manimanis/PFE-Maitrise/Extra/PrayerCall/interface.png

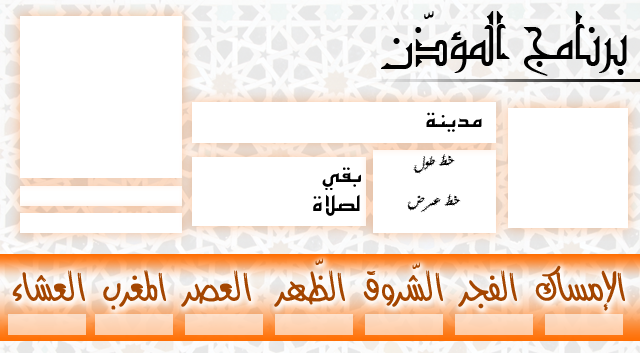
Extra/PrayerCall/interface.png
