manimanis/PFE-Maitrise/Readme.txt

Présentation Générale

PFE       : Prayers Caller
Etudiant  : MANI Mohamed Anis
N°        : 18498
Encadreur : Mr BESKRI Charfeddine

Le CD est organisé afin de faciliter la recherche des données.
