manimanis/PFE-Maitrise/Rapport/Annexes.pdf

Annexes

i

# Annexes

ii

## Sommaire

iii

## Liste des Figures

Figure 18, fenêtre d'édition des coordonnées géographiques d'une ville : VilleEditDialog

Figure 20, fenêtre d'édition des horaires de prières pour une ville : PrayersTimesDialog

Figure 21, fenêtre d'édition des horaires de prières pour une journée : PrayersEditDialog

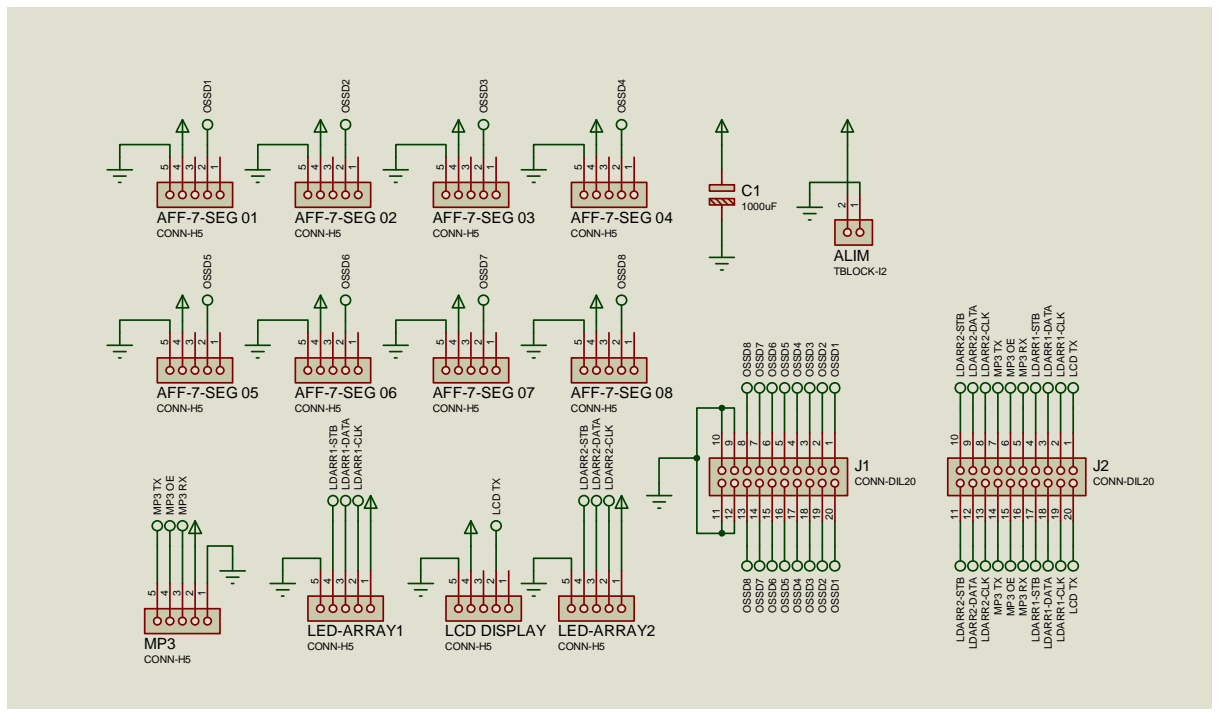
[picture p2: figure]
AFF-7-SEG 02; CONN-H5; OSSD2; AFF-7-SEG 01; OSSD1; AFF-7-SEG 03; OSSD3; AFF-7-SEG 04; OSSD4; AFF-7-SEG 05; OSSD5; LED-ARRAY1; CONN-H5 LDARR¹⁻STB LDARR¹⁻DATA LDARR1-CLK; ALIM; TBLOCK-I2; CONN-H5 MP³ TX MP³ OE MP³ RX; LCD DISPLAY; LCD TX; AFF-7-SEG 06; OSSD6; AFF-7-SEG 07; OSSD7; AFF-7-SEG 08; OSSD8; LED-ARRAY2; CONN-H5 LDARR²⁻STB LDARR²⁻DATA LDARR2-CLK; CONN-DIL20; LDARR2-STB; LDARR2-DATA; LDARR2-CLK; LDARR1-STB; LDARR1-DATA; LDARR1-CLK; LCD TX LCD TX

iv

# Annexe 1 -Schémas des montages électroniques

Les schémas de principe ont été dessinés à l'aide Proteus 7.7.
Le routage a été réalisé à l'aide de ARES. Ce logiciel offre une fonction de routage automatique. Cette fonction est très performante pour les circuits double faces. Pour les circuits simple face le résultat reste toujours décevant.

J'ai eu le choix entre :
- Utiliser des circuits imprimés double face pour bénéficier du routage automatique.
- Utiliser des circuits imprimés simple face et effectuer le routage manuellement.
La première solution présente aussi un inconvénient très grand lors de la soudure des composants : certains composants doivent être soudés sur les deux faces sans oublier les vias.
La deuxième solution semble plus adéquate bien : il faudrait passer des heures pour effectuer le routage tout en garantissant que le montage fonctionnera dès sa mise sous tension.

### 1. Commande des composants périphériques

Le montage suivant (figure 1) n'a d'autre utilité que de relier les différents modules du système avec le module principal.

Figure 1, Liaison entre le module principal et les afficheurs 7 segments

### 2. Module Affichage du jour de la semaine

# CONN-H5RX

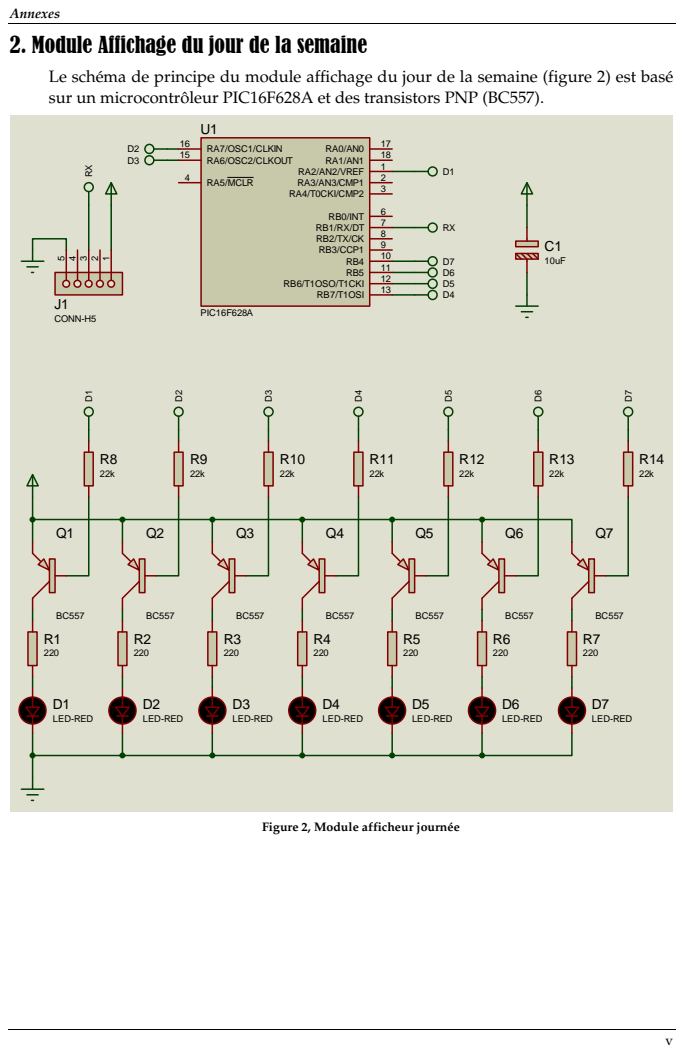
[picture p3: page 5]

Le schéma de principe du module affichage du jour de la semaine (figure 2) est basé
sur un microcontrôleur PIC16F628A et des transistors PNP (BC557).

Figure 2, Module afficheur journée

vi

### 3. Module d'alimentation

Le module d’alimentation (figure 3) supporte une tension d’entrée de 7,5V à 30V. Le régulateur utilisé (LM123K) est un régulateur fixe 5V - 3A. Il est monté sur le bornier J1.

Ce régulateur doit être monté sur un dissipateur thermique car la puissance maximale estimée dissipée est de l’ordre de :

Pdissipée = Udiff x Amax = (12 – 5) x 2 = 14W

La diode D1 sur l’entrée du module permet de protéger les condensateurs chimiques de filtrage contre une inversion de tension. Les condensateurs chimiques sont des condensateurs polarisés qui risquent d’exploser si on leur applique une tension négative.
La diode D2 est montée en cascade du régulateur afin de le protéger lors de la mise hors tension du montage. Les condensateurs en amont du régulateur se déchargent avant ceux situés en aval. Ce phénomène risque de créer une tension inverse aux bornes du régulateur qui pourrait le griller. La diode D2 conduit lors de la mise hors tension du montage pour permettre aux condensateurs en aval du régulateur de se décharger.

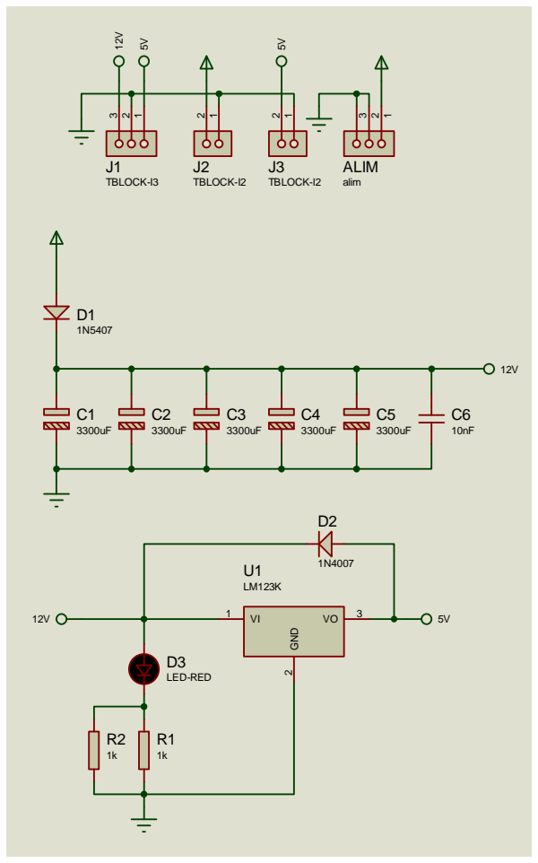
[picture p4: figure]
TBLOCK-I3 ¹²V; TBLOCK-I2; TBLOCK-I2 ⁵V; LED-RED; ALIM; alim; GND

Figure 3, Module d'alimentation

### 4. Module MP3

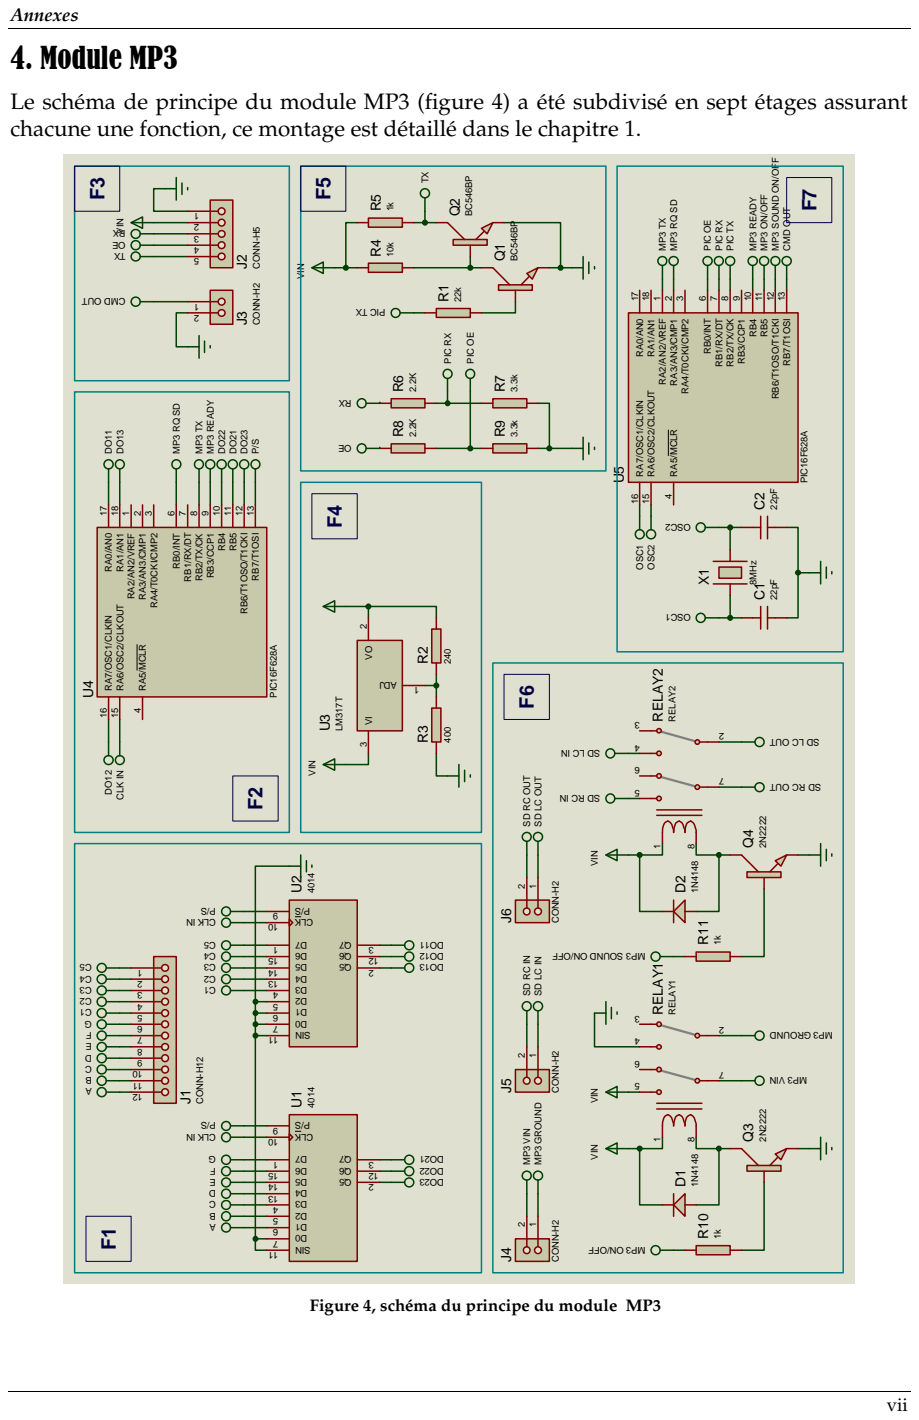
[picture p5: page 7]

Le schéma de principe du module MP3 (figure 4) a été subdivisé en sept étages assurant
chacune une fonction, ce montage est détaillé dans le chapitre 1.

Figure 4, schéma du principe du module MP3

### 5. Module afficheur LCD série

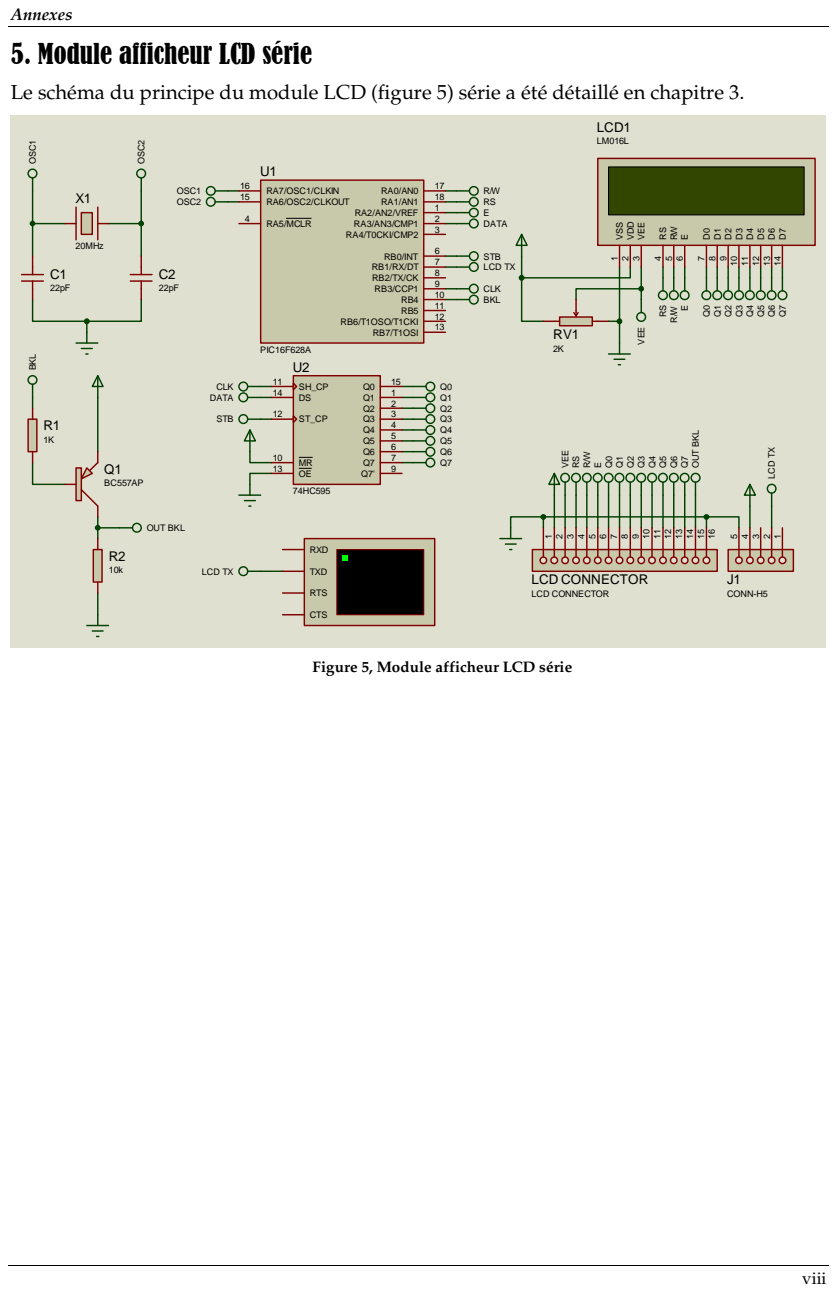
[picture p6: page 8]

Le schéma du principe du module LCD (figure 5) série a été détaillé en chapitre 3.

Figure 5, Module afficheur LCD série

### 6. Module afficheur 7 segments

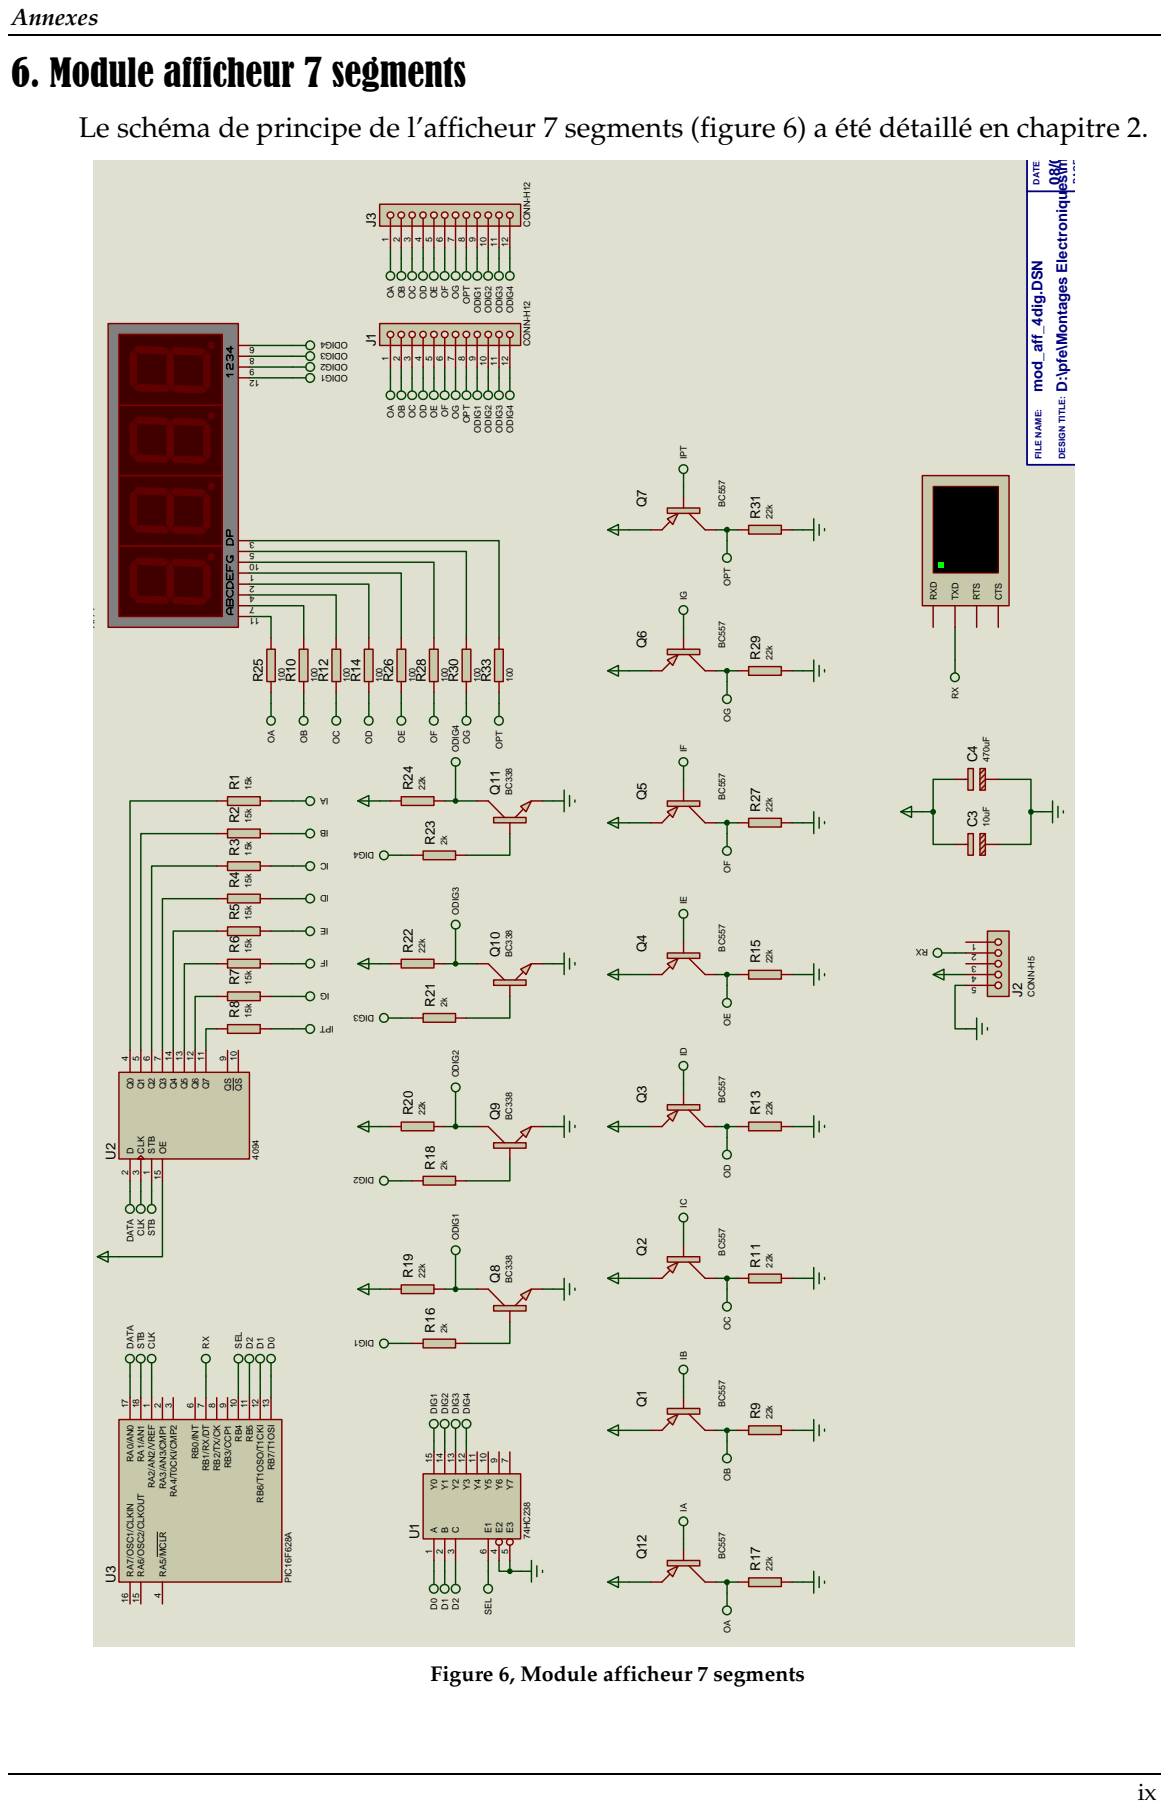
[picture p7: page 9]

08/09/2011 DESIGN TITLE: D:\pfe\Montages Electroniques\mod_aff_4digits\mod_a

Le schéma de principe de l’afficheur 7 segments (figure 6) a été détaillé en chapitre 2.

Figure 6, Module afficheur 7 segments

### 7. Module Principal

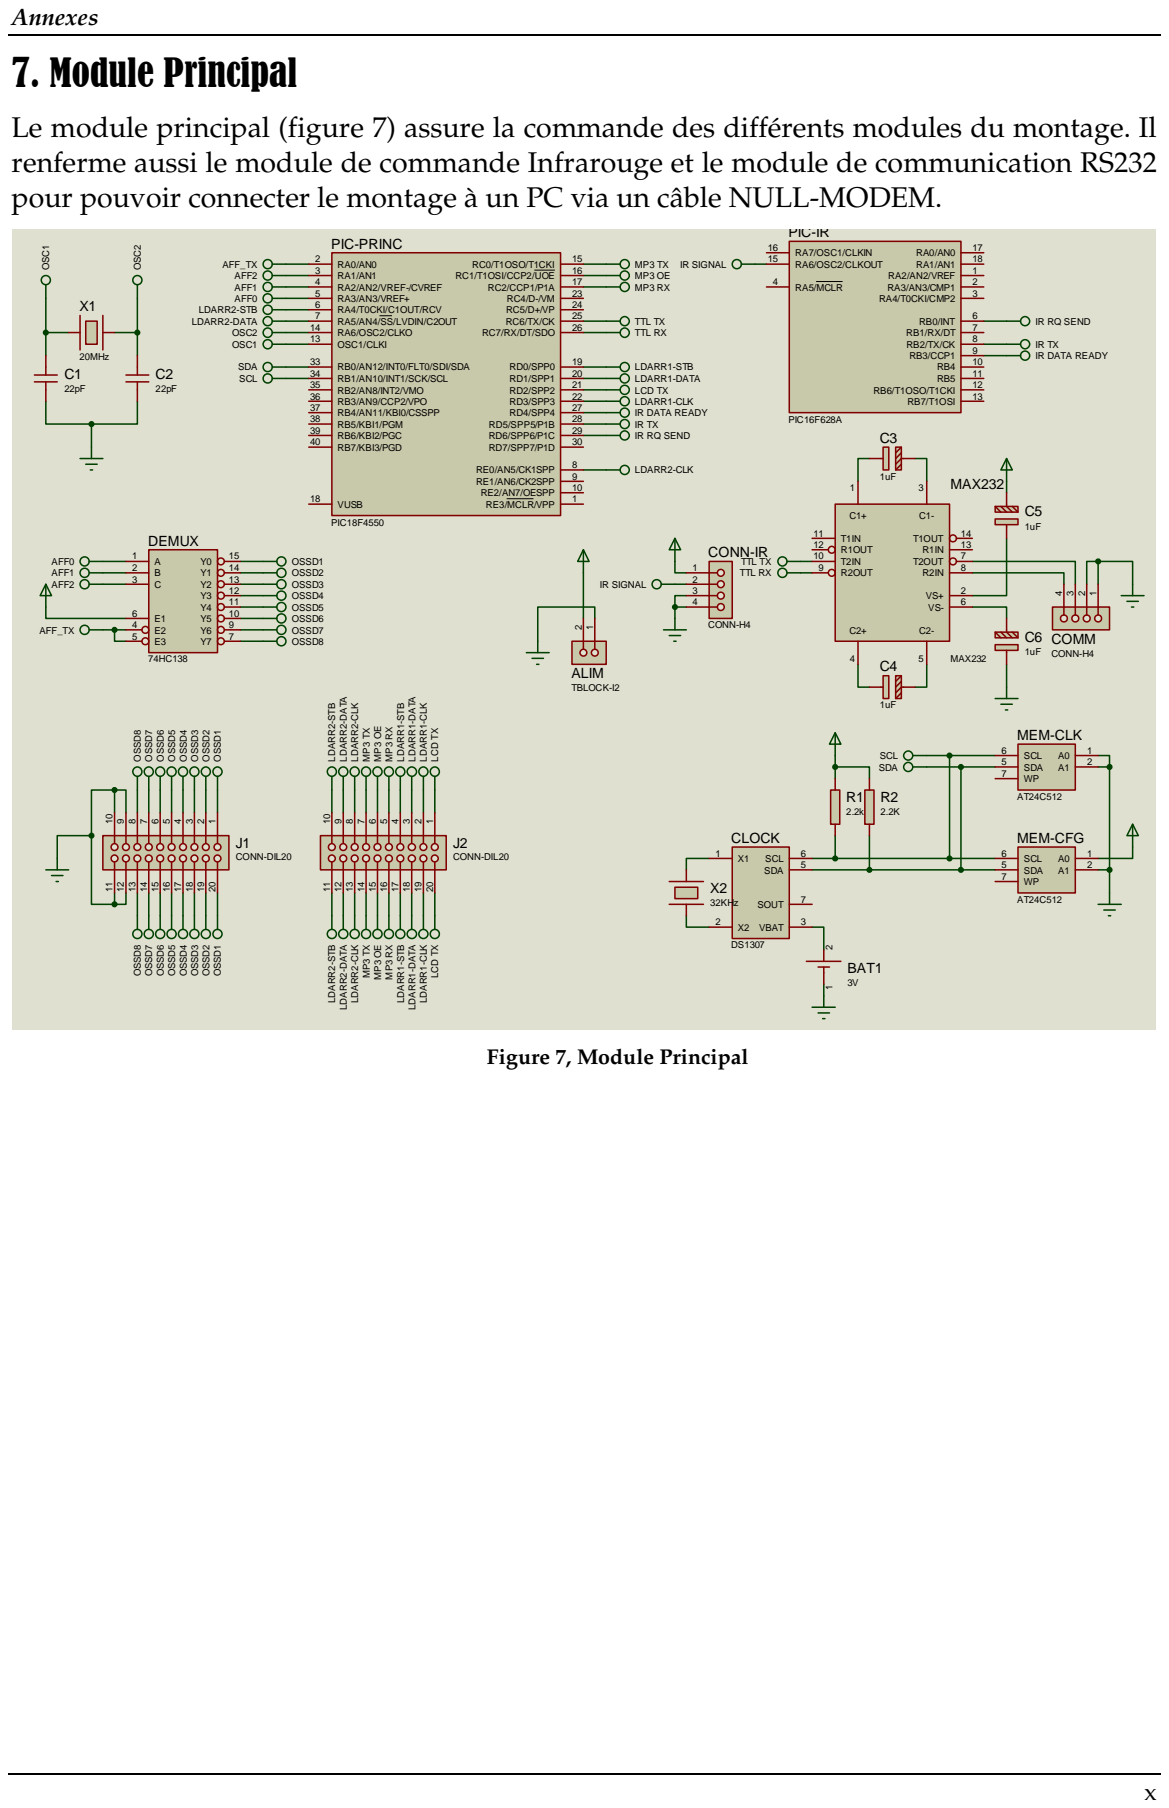
[picture p8: page 10]

Le module principal (figure 7) assure la commande des différents modules du montage. Il
renferme aussi le module de commande Infrarouge et le module de communication RS232
pour pouvoir connecter le montage à un PC via un câble NULL-MODEM.

LCD TX

xi

## Annexe 2 - Modèle de domaine

Dans ce modèle de domaine (figure 8) on essaye d’identifier les objets réels entrant dans la composition du système et de leurs attribuer des noms non ambigües.
Les noms attribués aux objets seront utilisés par la suite dans la rédaction des Use Cases.

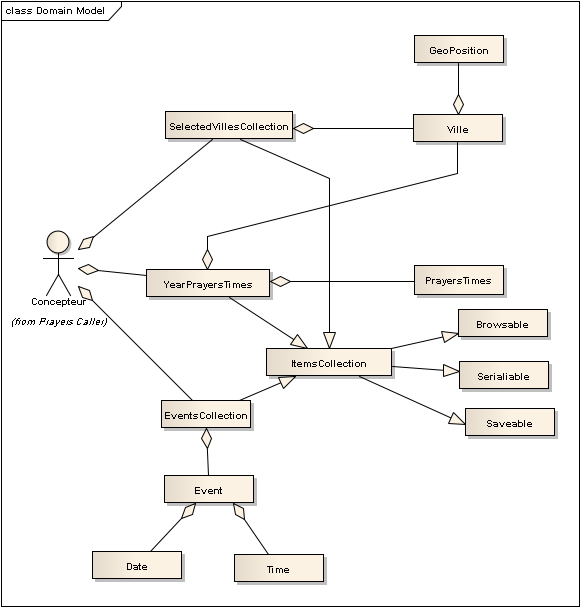
[picture p9: figure]

Figure 8, Modèle de domaine

xii

## Diagrammes de cas d'utilisation

### 1. Packages

Les packages permettent d’organiser l’ensemble des Use Cases (figure 9). Comme notre application assure cinq fonctions, les use cases ont été divisés conformément à ce nombre.
Les fonctions assurées sont :
- Sélectionner villes
- Editer coordonnées villes
- Editer horaires de prières
- Gérer les évènements
- Générer fichier Hex

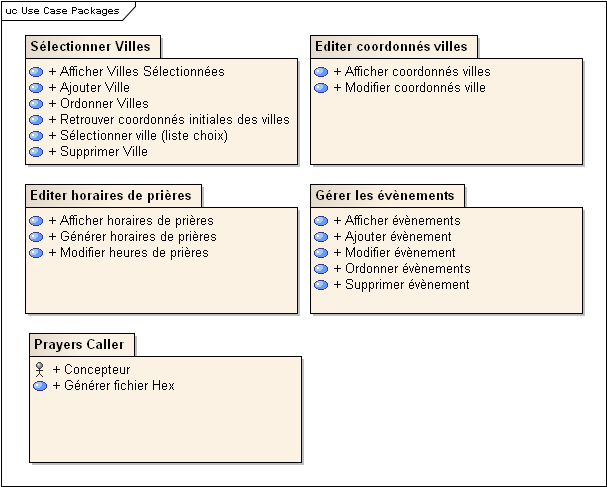
[picture p10: figure]

Figure 9, diagramme de packages

xiii

### 2. Diagramme Use case : Sélectionner ville

Le diagramme Use case : Sélectionner ville (figure 10) montre les actions que le concepteur (acteur du système) puisse réaliser dans le contexte du Use Case (Chapitre 7.2.a).

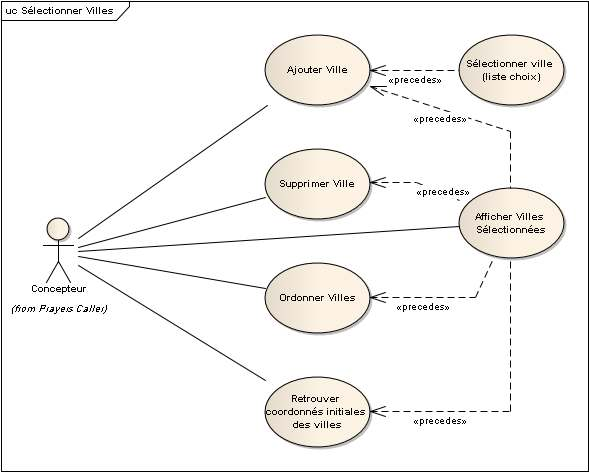
[picture p11: figure]

Figure 10, diagramme use case sélectionner ville

### 3. Diagramme Use case : Editer coordonnée villes

Le diagramme use case éditer coordonnées villes (figure 11) permet au concepteur de consulter la liste des villes sélectionnées, afficher et éditer leurs coordonnées (Chapitre 7.2.b).

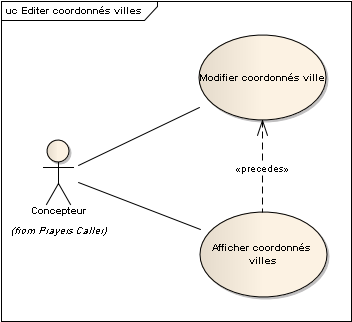
[picture p12: figure]

Figure 11, diagramme use case éditer coordonnées villes

### 4. Diagramme Use case : éditer horaires de prières

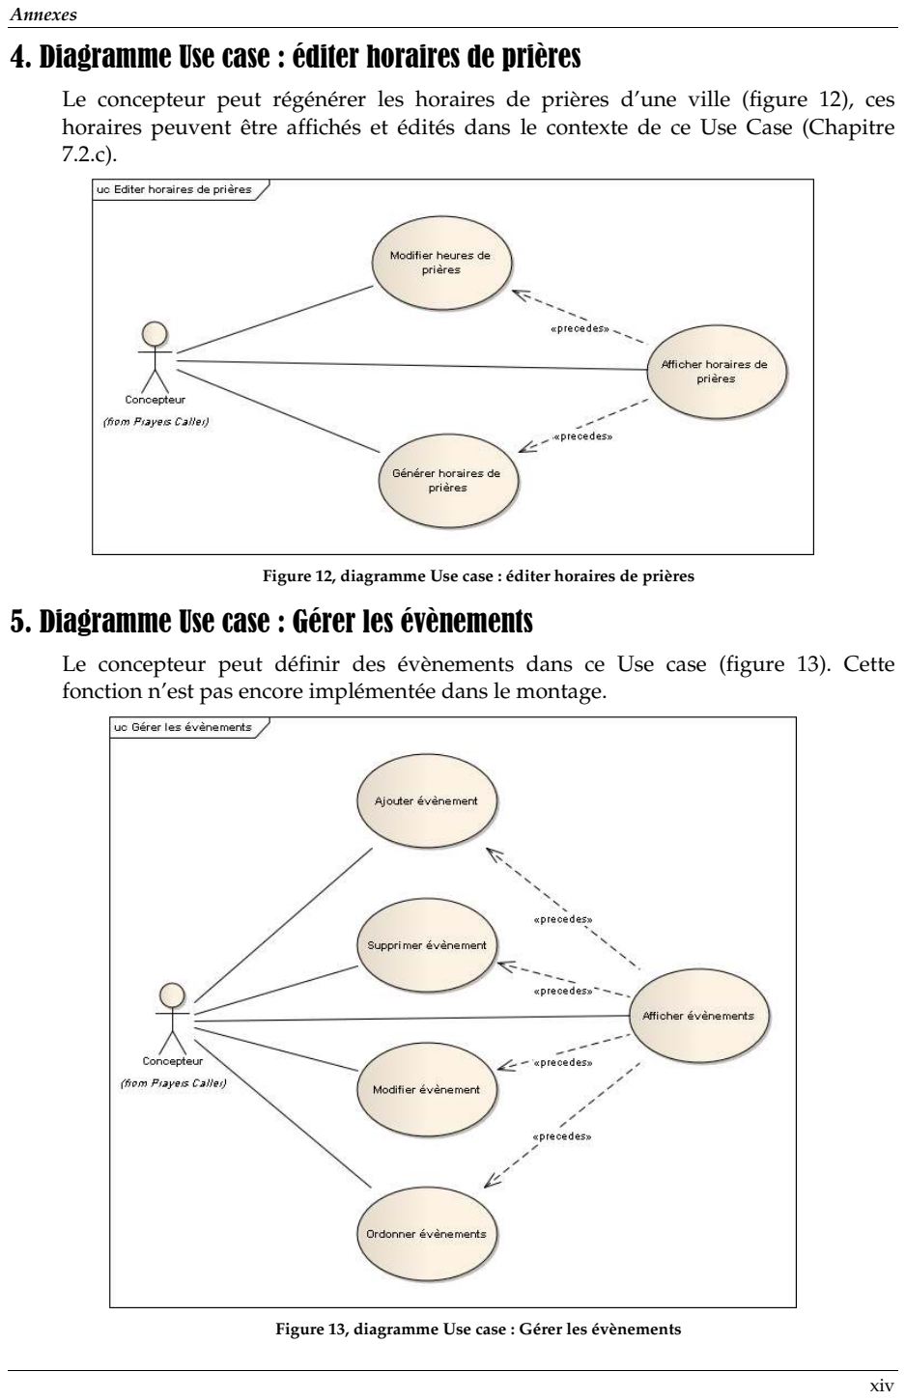
[picture p13: page 14]

xiv

Le concepteur peut régénérer les horaires de prières d’une ville (figure 12), ces horaires peuvent être affichés et édités dans le contexte de ce Use Case (Chapitre 7.2.c).

Figure 12, diagramme Use case : éditer horaires de prières

### 5. Diagramme Use case : Gérer les évènements

Le concepteur peut définir des évènements dans ce Use case (figure 13). Cette fonction n’est pas encore implémentée dans le montage.

Figure 13, diagramme Use case : Gérer les évènements

xv

### 6. Diagramme Use case : Prayer Caller

Le but ultime de cette application étant de pouvoir générer le fichier Hex, le Use Case (figure 14) suivant permet d’assurer cette fonction (Chapitre 7.2.d).

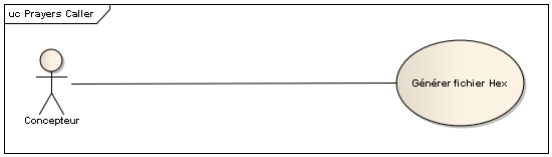
[picture p14: figure]

Figure 14, diagramme Use case : Prayer Caller

xvi

## Annexe 3 - Captures d'écran de l'interface de l'utilitaire PrayerCaller

### 1. MainFrame

La fenêtre principale de l’application (figure15).

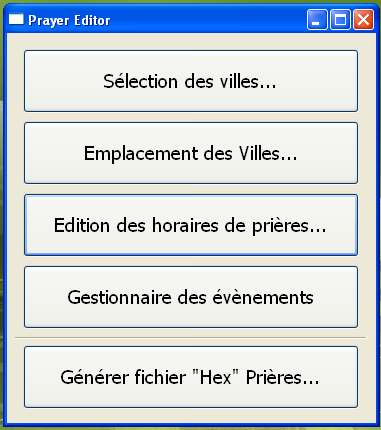
[picture p15: figure]

Figure 15, fenêtre principale : MainFrame

### 2. TownsSelectDialog

L’apparence de la fenêtre qui permet d’assurer le cas d’utilisation : Sélectionner villes (figure 16).

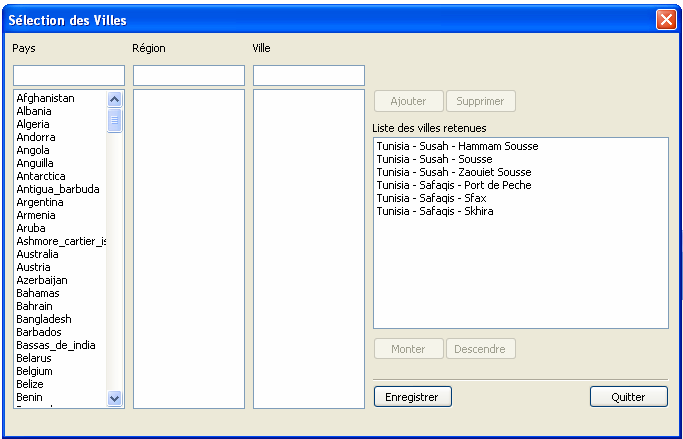
[picture p16: figure]

Figure 16, fenêtre de sélection de villes : TonwsSelectDialog

xvii

### 3. VillesDialog

La fenêtre suivante permet d’afficher les coordonnées des villes sélectionnées (figure 17).

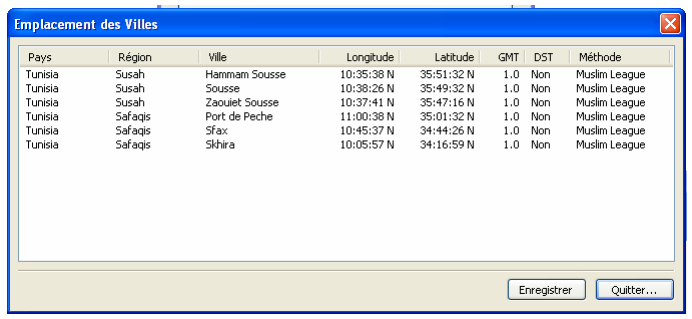
[picture p17: figure]

Figure 17, fenêtre d'édition des coordonnées des villes : VillesDialog

### 4. VilleEditDialog

Une ville sélectionnée dans la fenêtre VillesDialog peut être éditée grâce à la fenêtre suivante (figure 18).

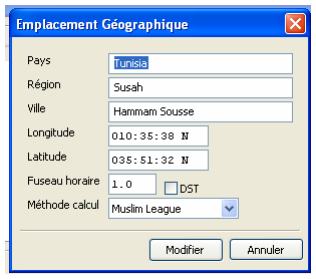
[picture p18: figure]

Figure 18, fenêtre d'édition des coordonnées géographiques d'une ville : VilleEditDialog

### 5. VilleChoiceDialog

Pour pouvoir générer/éditer les horaires de prières d’une ville il faudra commencer par la sélectionner dans la liste de la fenêtre suivante (figure 19).

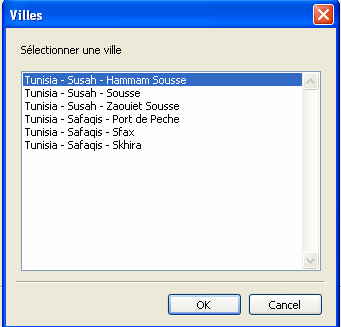
[picture p19: figure]

Figure 19, fenêtre de sélection d'une ville : VilleChoiceDialog

xviii

### 6. PrayersTimesDialog

La fenêtre suivante (figure 19) présente les horaires de prières d’une ville pour tous les jours de l’année. Le concepteur peut régénérer les horaires de prières si celles-ci ont été éditées d’une façon incorrecte.

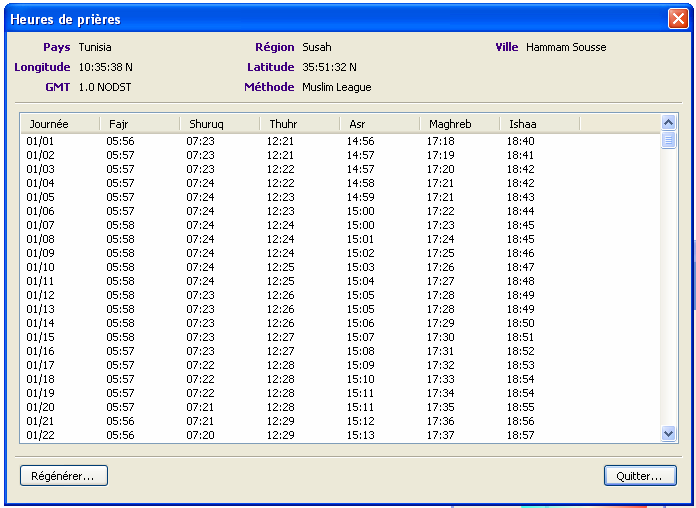
[picture p20: figure]

Figure 20, fenêtre d'édition des horaires de prières pour une ville : PrayersTimesDialog

### 7. PrayersEditDialog

L’édition des horaires de prières pour une journée est effectuée à travers la fenêtre suivante (figure 21). Cette fenêtre est accessible via un double clic sur un élément de la liste présentée dans la fenêtre PrayersTimesDialog.

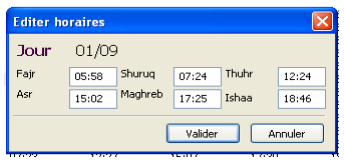
[picture p21: figure]

Figure 21, fenêtre d'édition des horaires de prières pour une journée : PrayersEditDialog

xix

### 8. EventsDialog

L’édition, l’ajout, la suppression, l’ordre des évènements sont accessibles à travers la fenêtre suivante (figure 22).

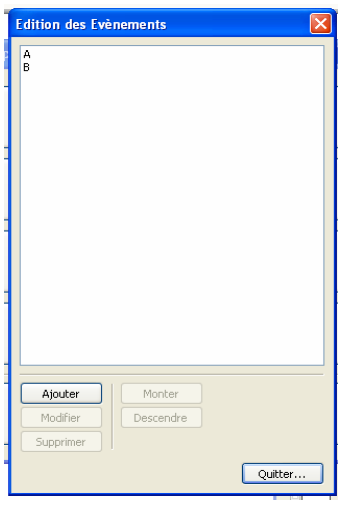
[picture p22: figure]

Figure 22, fenêtre d'édition des évènements :EventsDialog

### 10. EventsEditDialog

Le concepteur peut choisir la nature, la fréquence, les dates de déclenchement et les intervalles des évènements. Ces actions sont réalisées à travers la fenêtre suivante (figure 23). Cette partie reste non implémentée pour le moment.

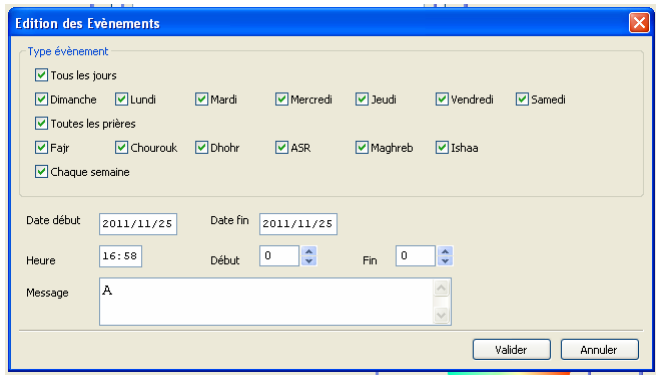
[picture p23: figure]

Figure 23, fenêtre d'édition d'un évènement : EventsEdirDialog
