manimanis/PFE-Maitrise/Rapport/page de garde.pdf

Institut Supérieur de l'Education et de la Formation Continue

Ministère de l'enseignement Supérieur

# Projet de fin d'études

# Conception et réalisation du prototype d'un montage pour afficher les horaires de prières

Réalisé Par

## MANI Mohamed Anis

Encadré Par

## Mr BESKRI Charfeddine

Semestre 57

2010/2011
