manimanis/PFE-Maitrise/Montages/Alimentation/alimentation.PDF

J1

# TBLOCK-I3 ¹²V 5V

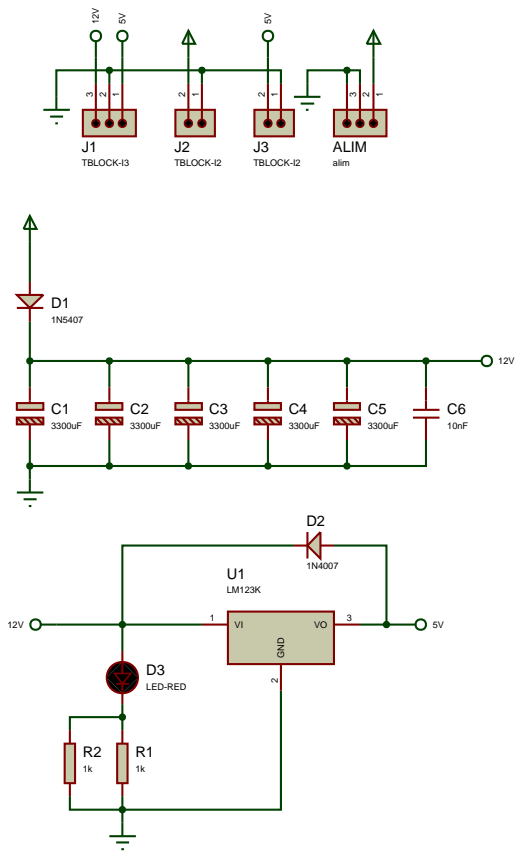
[picture p62: page 1]
