manimanis/PFE-Maitrise/Montages/Connexions/connexions.PDF

## AFF-7-SEG 02

## AFF-7-SEG 01

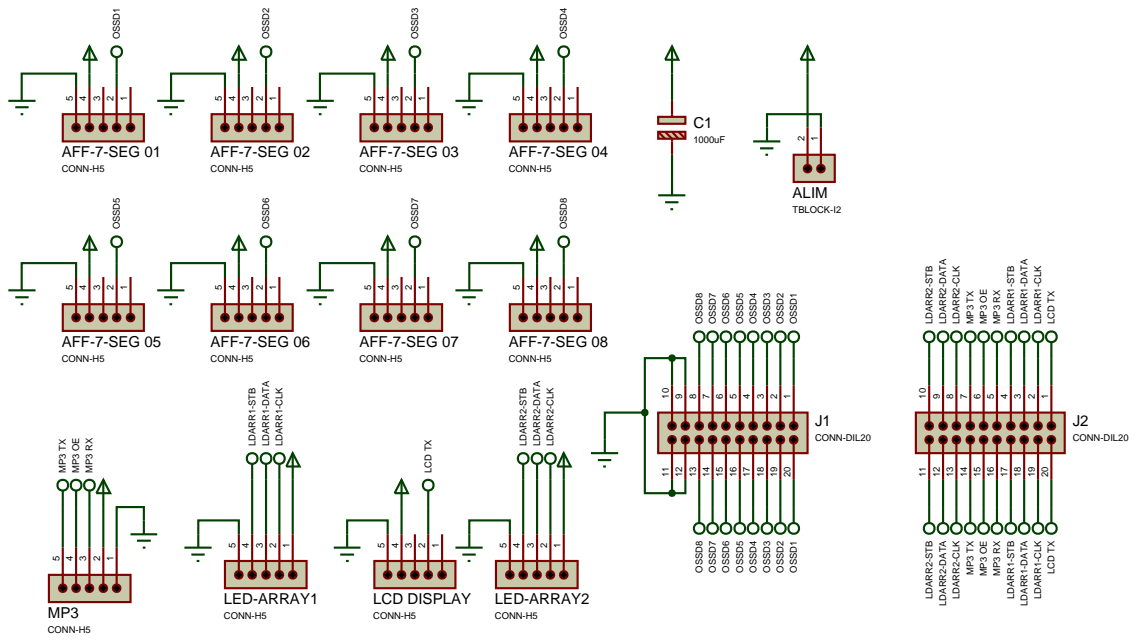
[picture p63: page 1]
CONN-H5; OSSD2; OSSD1; AFF-7-SEG 03; OSSD3; AFF-7-SEG 04; OSSD4; OSSD5; LED-ARRAY1; LDARR1-CLK; ALIM; TBLOCK-I2; LCD DISPLAY; LCD TX; OSSD6; OSSD7; AFF-7-SEG 08; OSSD8; LED-ARRAY2; LDARR2-CLK; CONN-DIL20; LDARR2-STB; LDARR2-DATA; LDARR1-STB; LDARR1-DATA

LCD TX

AFF-7-SEG 05
CONN-H5
CONN-H5 MP³ TX MP³ OE MP³ RX

AFF-7-SEG 06
CONN-H5LDARR¹⁻STB LDARR¹⁻DATA

AFF-7-SEG 07
CONN-H5LDARR²⁻STB LDARR²⁻DATA
