manimanis/PFE-Maitrise/Montages/Affichage jours/aff-jours.PDF

J1

# CONN-H5 RX

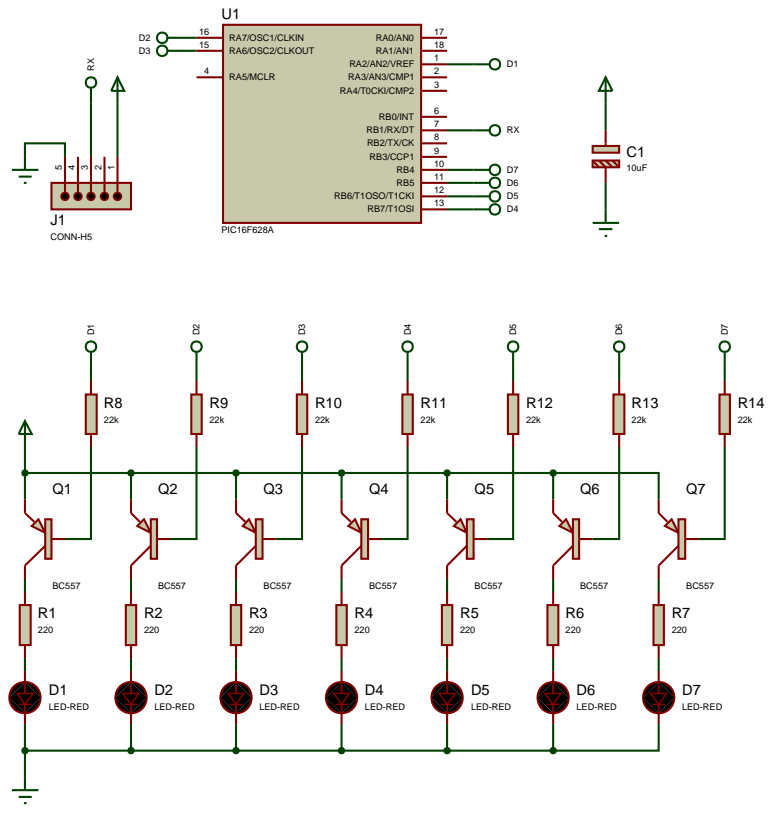
[picture p64: page 1]
