manimanis/PFE-Maitrise/Montages/Afficheur 7 segments/mod_aff_4dig.PDF

## AFF1

U2

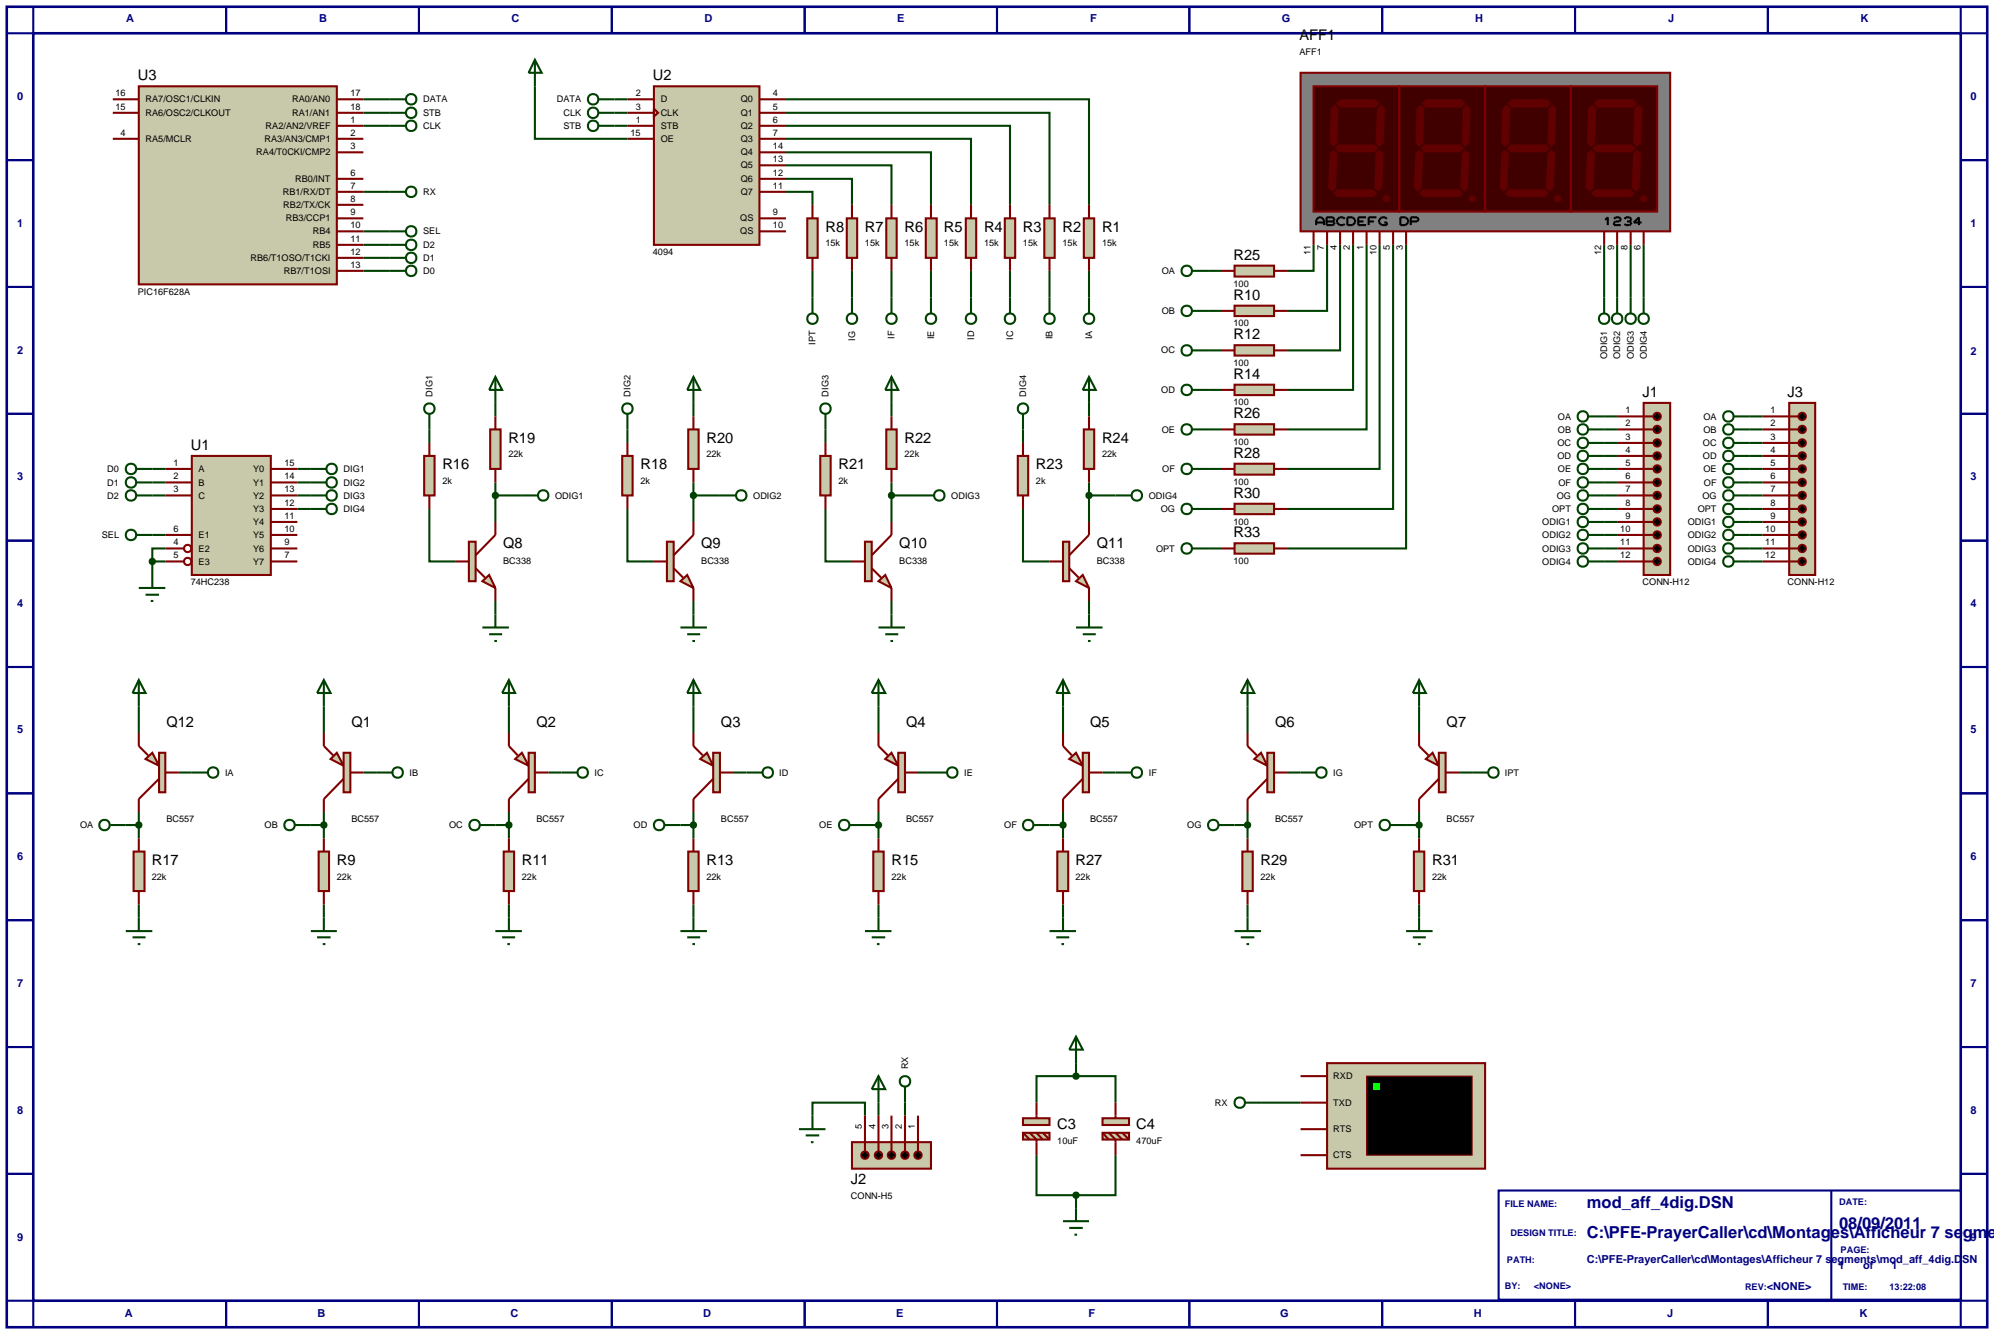
[picture p65: page 1]

FILE NAME:
DESIGN TITLE: C:\PFE-PrayerCaller\cd\Montages\Afficheur 7 segments\mod_aff_4dig.DSN
