manimanis/PFE-Maitrise/Montages/LCD Série/lcd.PDF

U1

## LCD1

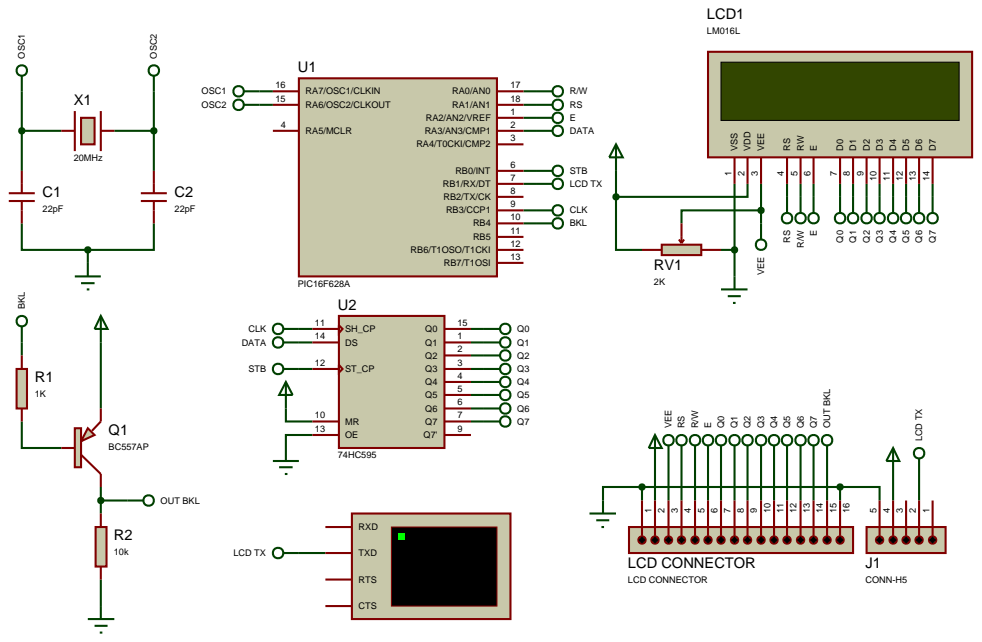
[picture p66: page 1]
