manimanis/PFE-Maitrise/Montages/Lecteur MP3/lecteur_mp3.PDF

J1

U4

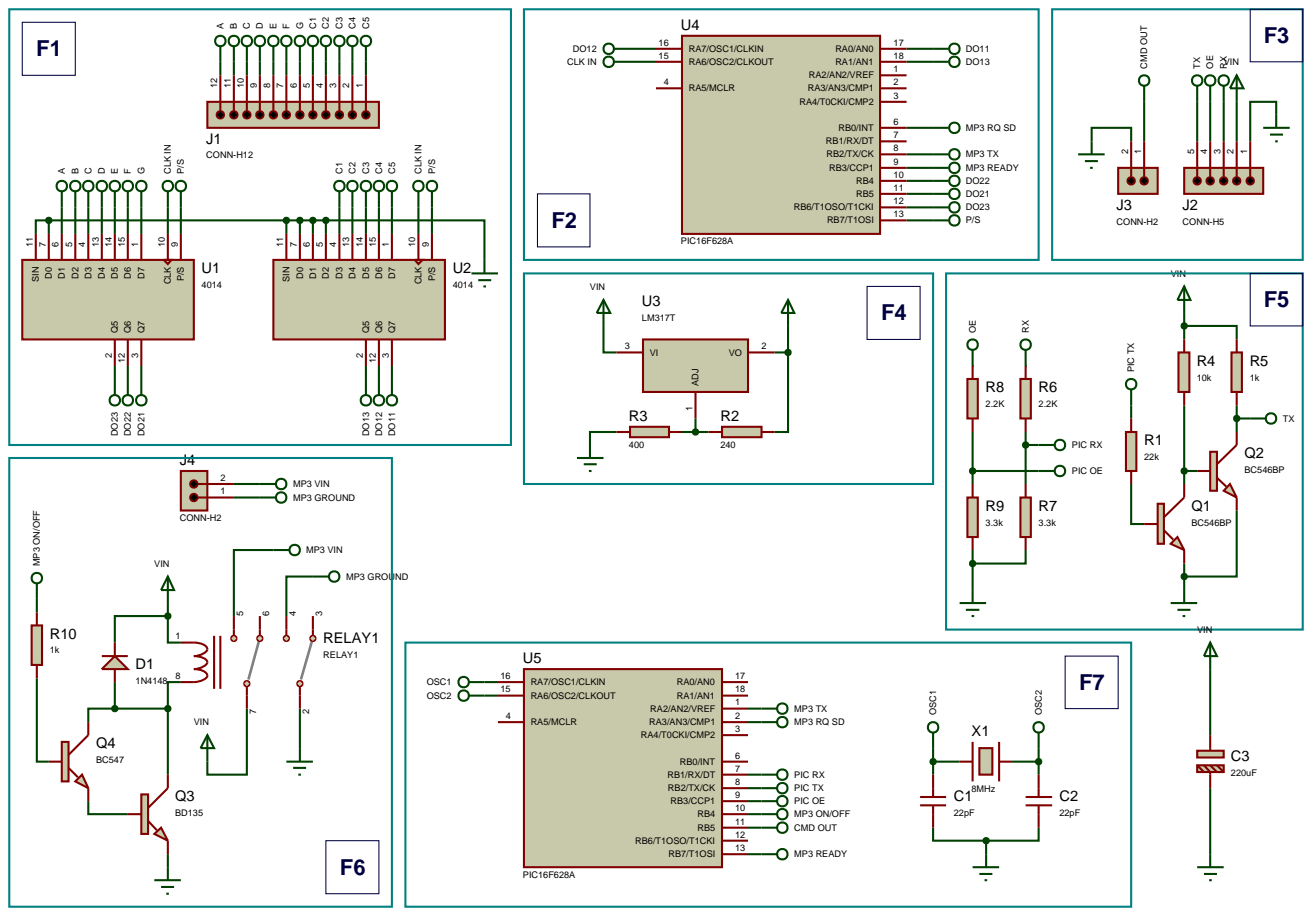
[picture p67: page 1]
