manimanis/PFE-Maitrise/Montages/Principal/principale2.PDF

## PIC-PRINC

C1

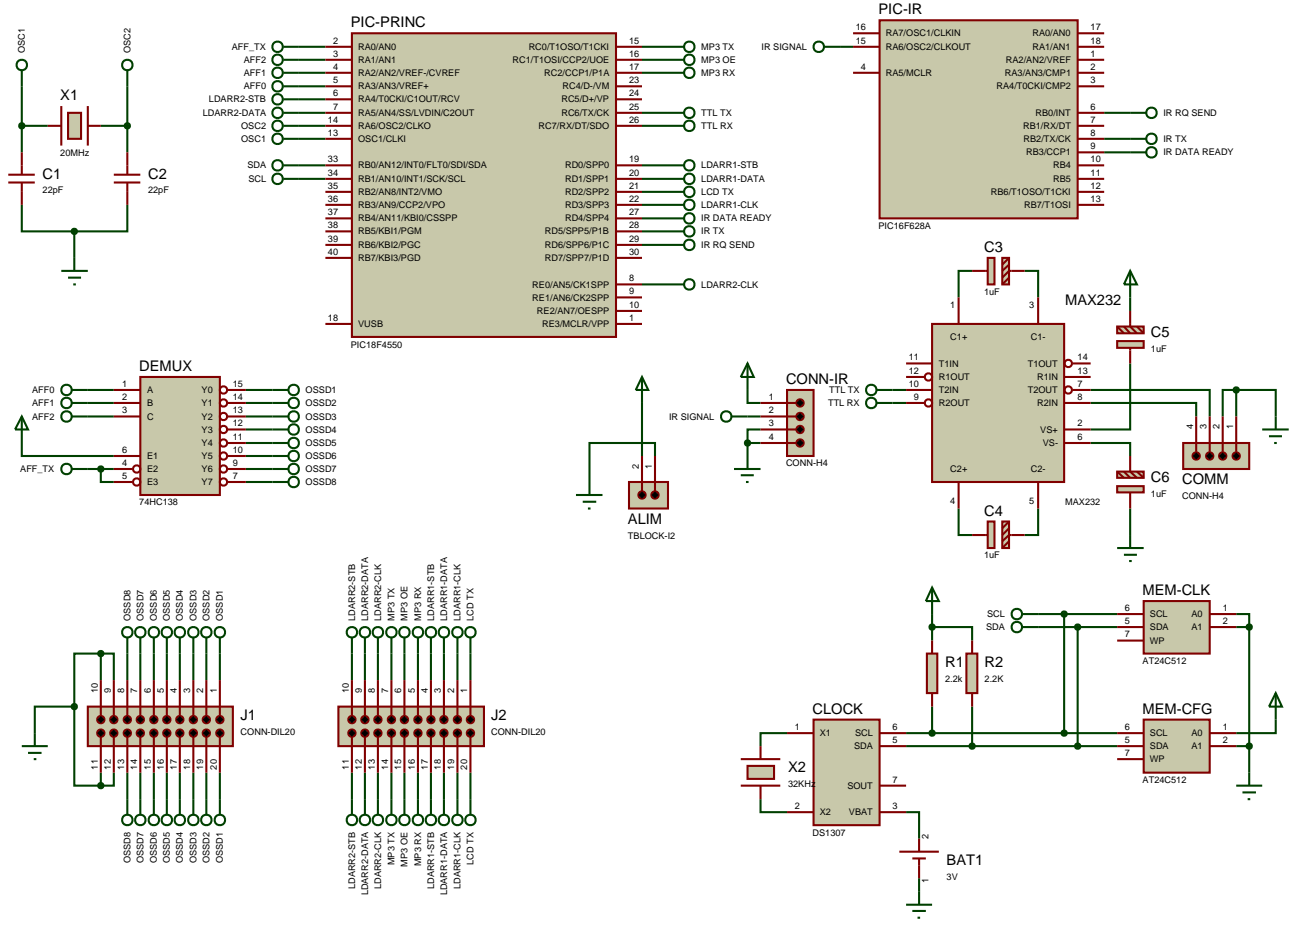
[picture p68: page 1]

LCD TX
