manimanis/PFE-Maitrise/(list of files, drawings)

Other design files:
Montages/Affichage jours/aff-jours.DSN
Montages/Affichage jours/aff-jours.LYT
Montages/Afficheur 7 segments/mod_aff_4dig.DSN
Montages/Afficheur 7 segments/mod_afficheur_4digits.LYT
Montages/Afficheur 7 segments/mod_commande.LYT
Montages/Alimentation/alimentation.DSN
Montages/Alimentation/alimentation.LYT
Montages/Alimentation/alimentation.pdsprj
Montages/Connexions/connexions.DSN
Montages/Connexions/connexions_afficheurs.LYT
Montages/Connexions/connexions_mp3_lcd_jours.LYT
Montages/Horloge/accessoires/accessoires.pdsprj
Montages/Horloge/Horloge.pdsprj
Montages/LCD Série/lcd.DSN
Montages/LCD Série/lcd.LYT
Montages/Lecteur MP3/lecteur_mp3.DSN
Montages/Lecteur MP3/lecteur_mp3.LYT
Montages/Principal/principale2.DSN
Montages/Principal/principale.LYT
