manimanis/PFE-Maitrise/Montages/Horloge/main.c

#include <main.h>
#include <ds1307.c>

#define FRACTIONS 75
#define ADD_VALUE 301
#define SUB_VALUE 723

int cntfs;
int mode = 0;

int display[4];

int16 somme = 0;

int convert(int v) {
   switch(v) {
      case 0: return 0xEE;
      case 1: return 0x22;
      case 2: return 0xD6;
      case 3: return 0x76;
      case 4: return 0x3A;
      case 5: return 0x7C;
      case 6: return 0xFC;
      case 7: return 0x2E;
      case 8: return 0xFE;
      case 9: return 0x7E;
   }
   return 0x00;
}

void serialize_data() {
   int j, i, v, octet;
   
   for (j = 0 ; j < 4 ; j++) {
      octet = display[j];
      v = 0x80;
      for (i = 0 ; i < 8 ; i++) {
         if (octet & v) {
            output_high(DATA);
         } else {
            output_low(DATA);
         }
         output_high(CLK);
         output_low(CLK);
         v = v >> 1;
      }
   }
   output_high(STB);
   output_low(STB);
}

void update_display() {
      display[0] = convert(clk_data[MINUTE] % 10);
      display[1] = convert(clk_data[MINUTE] / 10);
      display[2] = convert(clk_data[HOUR] % 10);
      display[3] = convert(clk_data[HOUR] / 10);
      
      disable_interrupts(GLOBAL);
      serialize_data();
      enable_interrupts(GLOBAL);
}

int1 display_dirty = TRUE,
     data_dirty = TRUE,
     step_down = FALSE,
     step_up = FALSE;
     
int1 input1 = TRUE, input2 = TRUE, input3 = TRUE, input4 = TRUE,
     linput1 = TRUE, linput2 = TRUE, linput3 = TRUE, linput4 = TRUE;

#int_timer0
void timer0_isr() {
   if (mode == 0) {
      if (cntfs > 37) {
         output_high(DOTS_IN);
      } else {
         output_low(DOTS_IN);
      }
      
      if (cntfs == 0) {
         clk_data[SECOND]++;
         if (clk_data[SECOND] == 60) {
            display_dirty = TRUE;
            clk_data[MINUTE]++;
            clk_data[SECOND] = 0;
            if (clk_data[MINUTE] == 60) {
               clk_data[HOUR]++;
               clk_data[MINUTE] = 0;
               if (clk_data[HOUR] == 24) {
                  clk_data[HOUR] = 0;
               }
            }
         }
      
         if (somme < SUB_VALUE) {
            cntfs = FRACTIONS;
            somme += ADD_VALUE;
         } else {
            cntfs = FRACTIONS + 1;
            somme -= SUB_VALUE;
         }
         
         if (somme == 0) {
            data_dirty = TRUE;
         }
      } else {
         cntfs--;
      }
   } else if (mode == 1 || mode == 2) {
      input3 = input(IN3);
      input4 = input(IN4);
      
      if (!step_down && !input3 && !linput3) {
         if (cntfs == 0) {
            step_down = TRUE;
            cntfs = FRACTIONS >> 1;
         } else {
            cntfs--;
         }
      } else if (!step_down && input3 && !linput3) {
         cntfs = FRACTIONS >> 1;
         step_down = TRUE;
      } else if (!step_up && !input4 && !linput4) {
         if (cntfs == 0) {
            step_up = TRUE;
            cntfs = FRACTIONS >> 1;
         } else {
            cntfs--;
         }
      } else if (!step_up && input4 && !linput4) {
         cntfs = FRACTIONS >> 1;
         step_up = TRUE;
      } 
      
      linput3 = input3;
      linput4 = input4;
   }
}

void main() {
   
   int v = 0x01;
   for (cntfs = 0 ; cntfs < 8 ; cntfs++) {
      display[0] = v;
      display[1] = v;
      display[2] = v;
      display[3] = v;
      disable_interrupts(GLOBAL);
      serialize_data();
      enable_interrupts(GLOBAL);
      delay_ms(500);
      v = v << 1;
   }
   
   clk_init();
   clk_read();
   if (!clk_is_started()) {
      clk_start();
   }
   setup_timer_0(RTCC_INTERNAL | RTCC_DIV_256);
      
   enable_interrupts(INT_TIMER0);
   enable_interrupts(GLOBAL);
   
   while(TRUE){
      /** mode 0 **/
      while (mode == 0) {
         if (data_dirty == TRUE) {
            disable_interrupts(GLOBAL);
            do {
               clk_read();
               delay_ms(50);
            } while (clk_data[HOUR] != clk_last[HOUR] ||
                     clk_data[MINUTE] != clk_last[MINUTE]);
            display_dirty = TRUE;
            cntfs = FRACTIONS;
            somme = 0;
            
            data_dirty = FALSE;
            enable_interrupts(GLOBAL);
         }
         
         if (display_dirty == TRUE) {
            update_display();
            display_dirty = FALSE;
         }
         
         input1 = input(IN1);
         input2 = input(IN2);
         input3 = input(IN3);
         if (input1 && !linput1) {
            mode = 1;
         } else if (input2 && !linput2) {
            data_dirty = TRUE;
            delay_ms(1000);
         } else if (input3 && !linput3) {
            reset_cpu();
         }
         linput1 = input1;
         linput2 = input2;
         linput3 = input3;
      }
      /*- mode 0 -*/
      
      output_low(DOTS_IN);
      
      /** mode 1 **/
      display[0] = 0x00;
      display[1] = 0x00;
      display_dirty = TRUE;
      cntfs = FRACTIONS >> 1;
      while (mode == 1) {
         input1 = input(IN1);
         input2 = input(IN2);
         
         if (display_dirty == TRUE) {
            display[2] = convert(clk_data[HOUR] % 10);
            display[3] = convert(clk_data[HOUR] / 10);
            
            disable_interrupts(GLOBAL);
            serialize_data();
            enable_interrupts(GLOBAL);
            
            display_dirty = FALSE;
         }
          
         if (input1 && !linput1) {
            mode = 2;
         } else if (input2 && !linput2) {
            mode = 5;
         } else if (step_down) {
            if (clk_data[HOUR] == 0) {
               clk_data[HOUR] = 23;
            } else {
               clk_data[HOUR]--;
            }
            step_down = FALSE;
            display_dirty = TRUE;
         } else if (step_up) {
            if (clk_data[HOUR] == 23) {
               clk_data[HOUR] = 0;
            } else {
               clk_data[HOUR]++;
            }
            step_up = FALSE;
            display_dirty = TRUE;
         }
         
         linput1 = input1;
         linput2 = input2;
      }
      /*- mode 1 -*/
      
      /** mode 2 **/
      display[2] = 0x00;
      display[3] = 0x00;
      display_dirty = TRUE;
      while (mode == 2) {
         input1 = input(IN1);
         input2 = input(IN2);
          
          if (display_dirty == TRUE) {
            display[0] = convert(clk_data[MINUTE] % 10);
            display[1] = convert(clk_data[MINUTE] / 10);
            
            disable_interrupts(GLOBAL);
            serialize_data();
            enable_interrupts(GLOBAL);
            
            display_dirty = FALSE;
         }
         
         if (input1 && !linput1) {
            mode = 3;
         } else if (input2 && !linput2) {
            mode = 5;
         } else if (step_down) {
            if (clk_data[MINUTE] == 0) {
               clk_data[MINUTE] = 59;
            } else {
               clk_data[MINUTE]--;
            }
            step_down = FALSE;
            display_dirty = TRUE;
         } else if (step_up) {
            if (clk_data[MINUTE] == 59) {
               clk_data[MINUTE] = 0;
            } else {
               clk_data[MINUTE]++;
            }
            step_up = FALSE;
            display_dirty = TRUE;
         }
         
         linput1 = input1;
         linput2 = input2;
      }
      /*- mode 2 -*/
      
      /** mode 3 **/
      update_display();
      while (mode == 3) {
         input1 = input(IN1);
         input2 = input(IN2);
          
         if (input1 && !linput1) {
            mode = 4;
         } else if (input2 && !linput2) {
            mode = 5;
         }
         
         linput1 = input1;
         linput2 = input2;
      }
      /*- mode 3 -*/
      
      /** mode 4 **/
      if (mode == 4) {
         disable_interrupts(GLOBAL);
         clk_set_time(dec2bcd(clk_data[HOUR]), dec2bcd(clk_data[MINUTE]));
         enable_interrupts(GLOBAL);
         
         data_dirty = FALSE;
         display_dirty = TRUE;
         cntfs = FRACTIONS;
         somme = 0;
         
         mode = 0;
      }
      /** mode 4 **/
      
      if (mode == 5) {
         data_dirty = TRUE;
         mode = 0;
      }
   }

}
